BruceTanner/EPNET/README.md

# EPNET
Enterprise Computer Network Interface

This project is hardware and software for a network interface card for the Enterprise computer.
