BruceTanner/EPNET/HW/readme.txt

These files are the schematic and PCB layout for EPNET.

==============================================================================

 Copyright (C) 2015  Bruce Tanner

    These files are free: you can redistribute them and/or modify
    them under the terms of the GNU General Public License as published by
    the Free Software Foundation, either version 3 of the License, or
    (at your option) any later version.

    These files are distributed in the hope that they will be useful,
    but WITHOUT ANY WARRANTY; without even the implied warranty of
    MERCHANTABILITY or FITNESS FOR A PARTICULAR PURPOSE.  See the
    GNU General Public License for more details.

    You should have received a copy of the GNU General Public License
    along with this program.  If not, see <http://www.gnu.org/licenses/>.

 If you do use or modify these files, either for their original purpose or for
 something new, I'd love to hear about it! I can be contacted by email at:

 brucetanner@btopenworld.com

==============================================================================
