BruceTanner/EPNET/HW/pcb.png

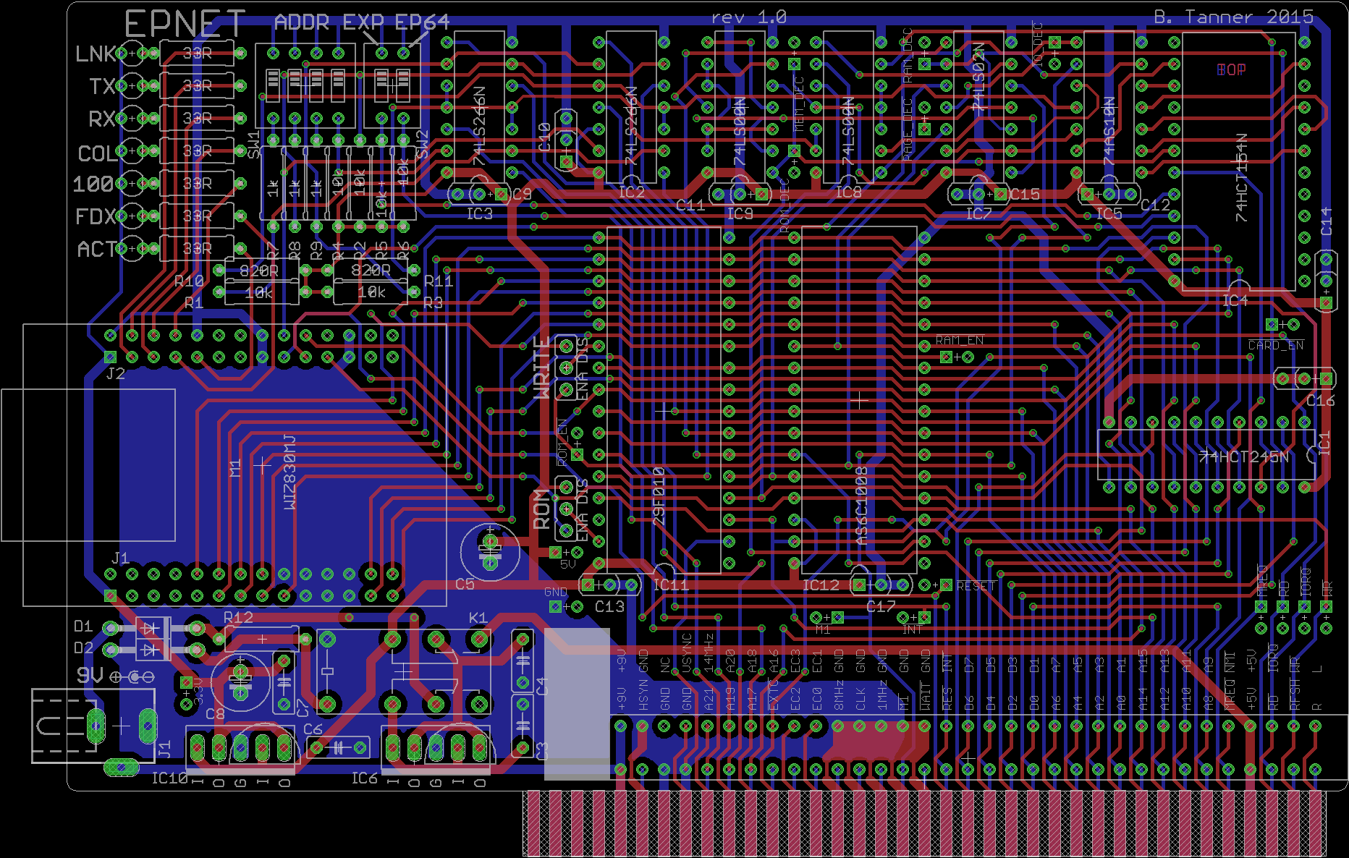
HW/pcb.png
