BruceTanner/EPNET/HW/Schematic.png

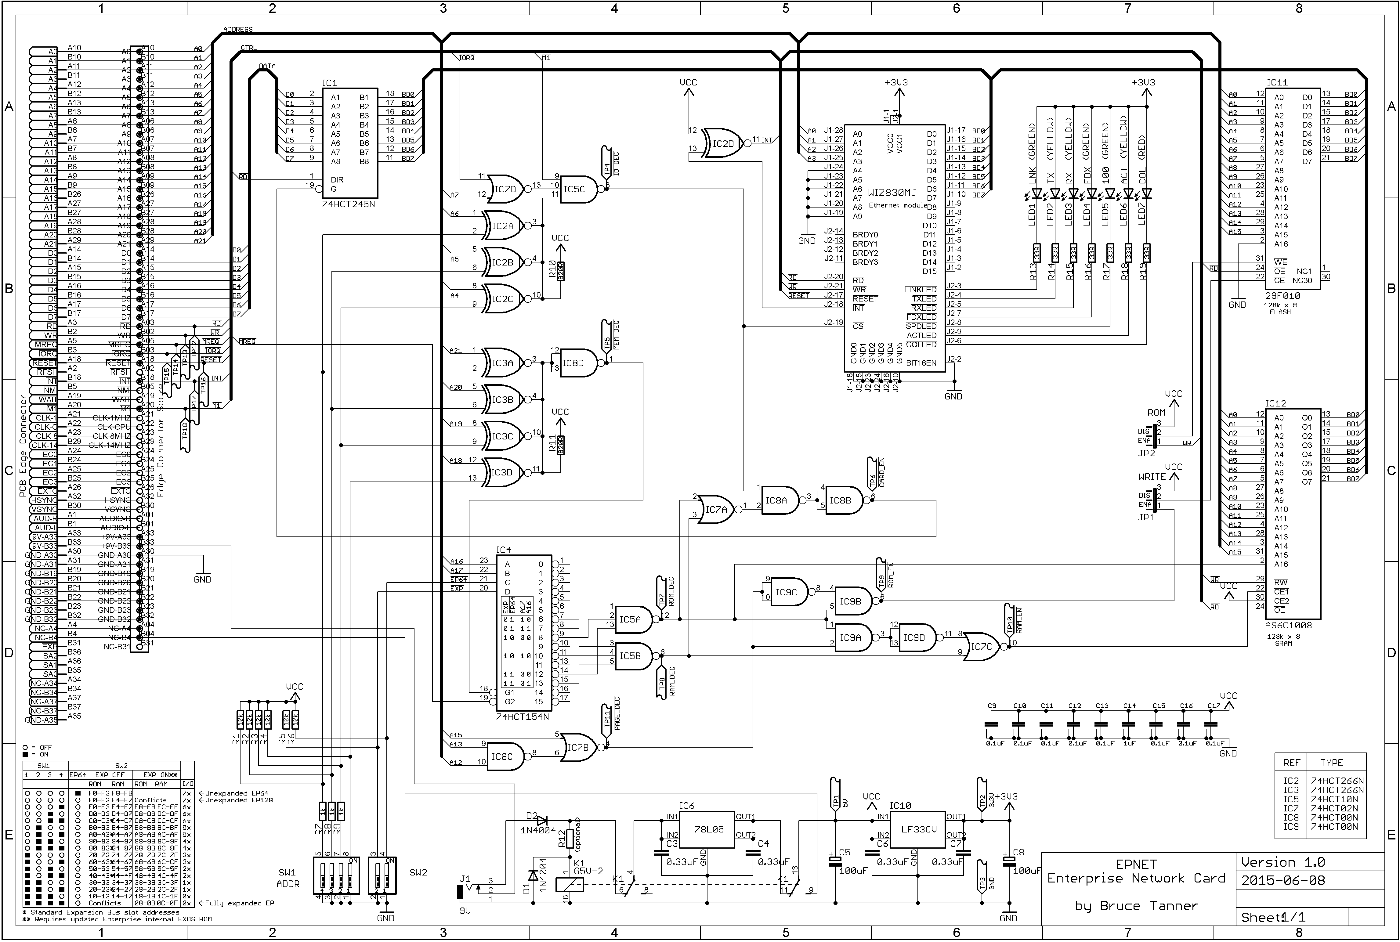
HW/Schematic.png
