BruceTanner/EPNET/HW/epnet.brd

## EAGLE design HW/epnet.brd (2015-11-03)

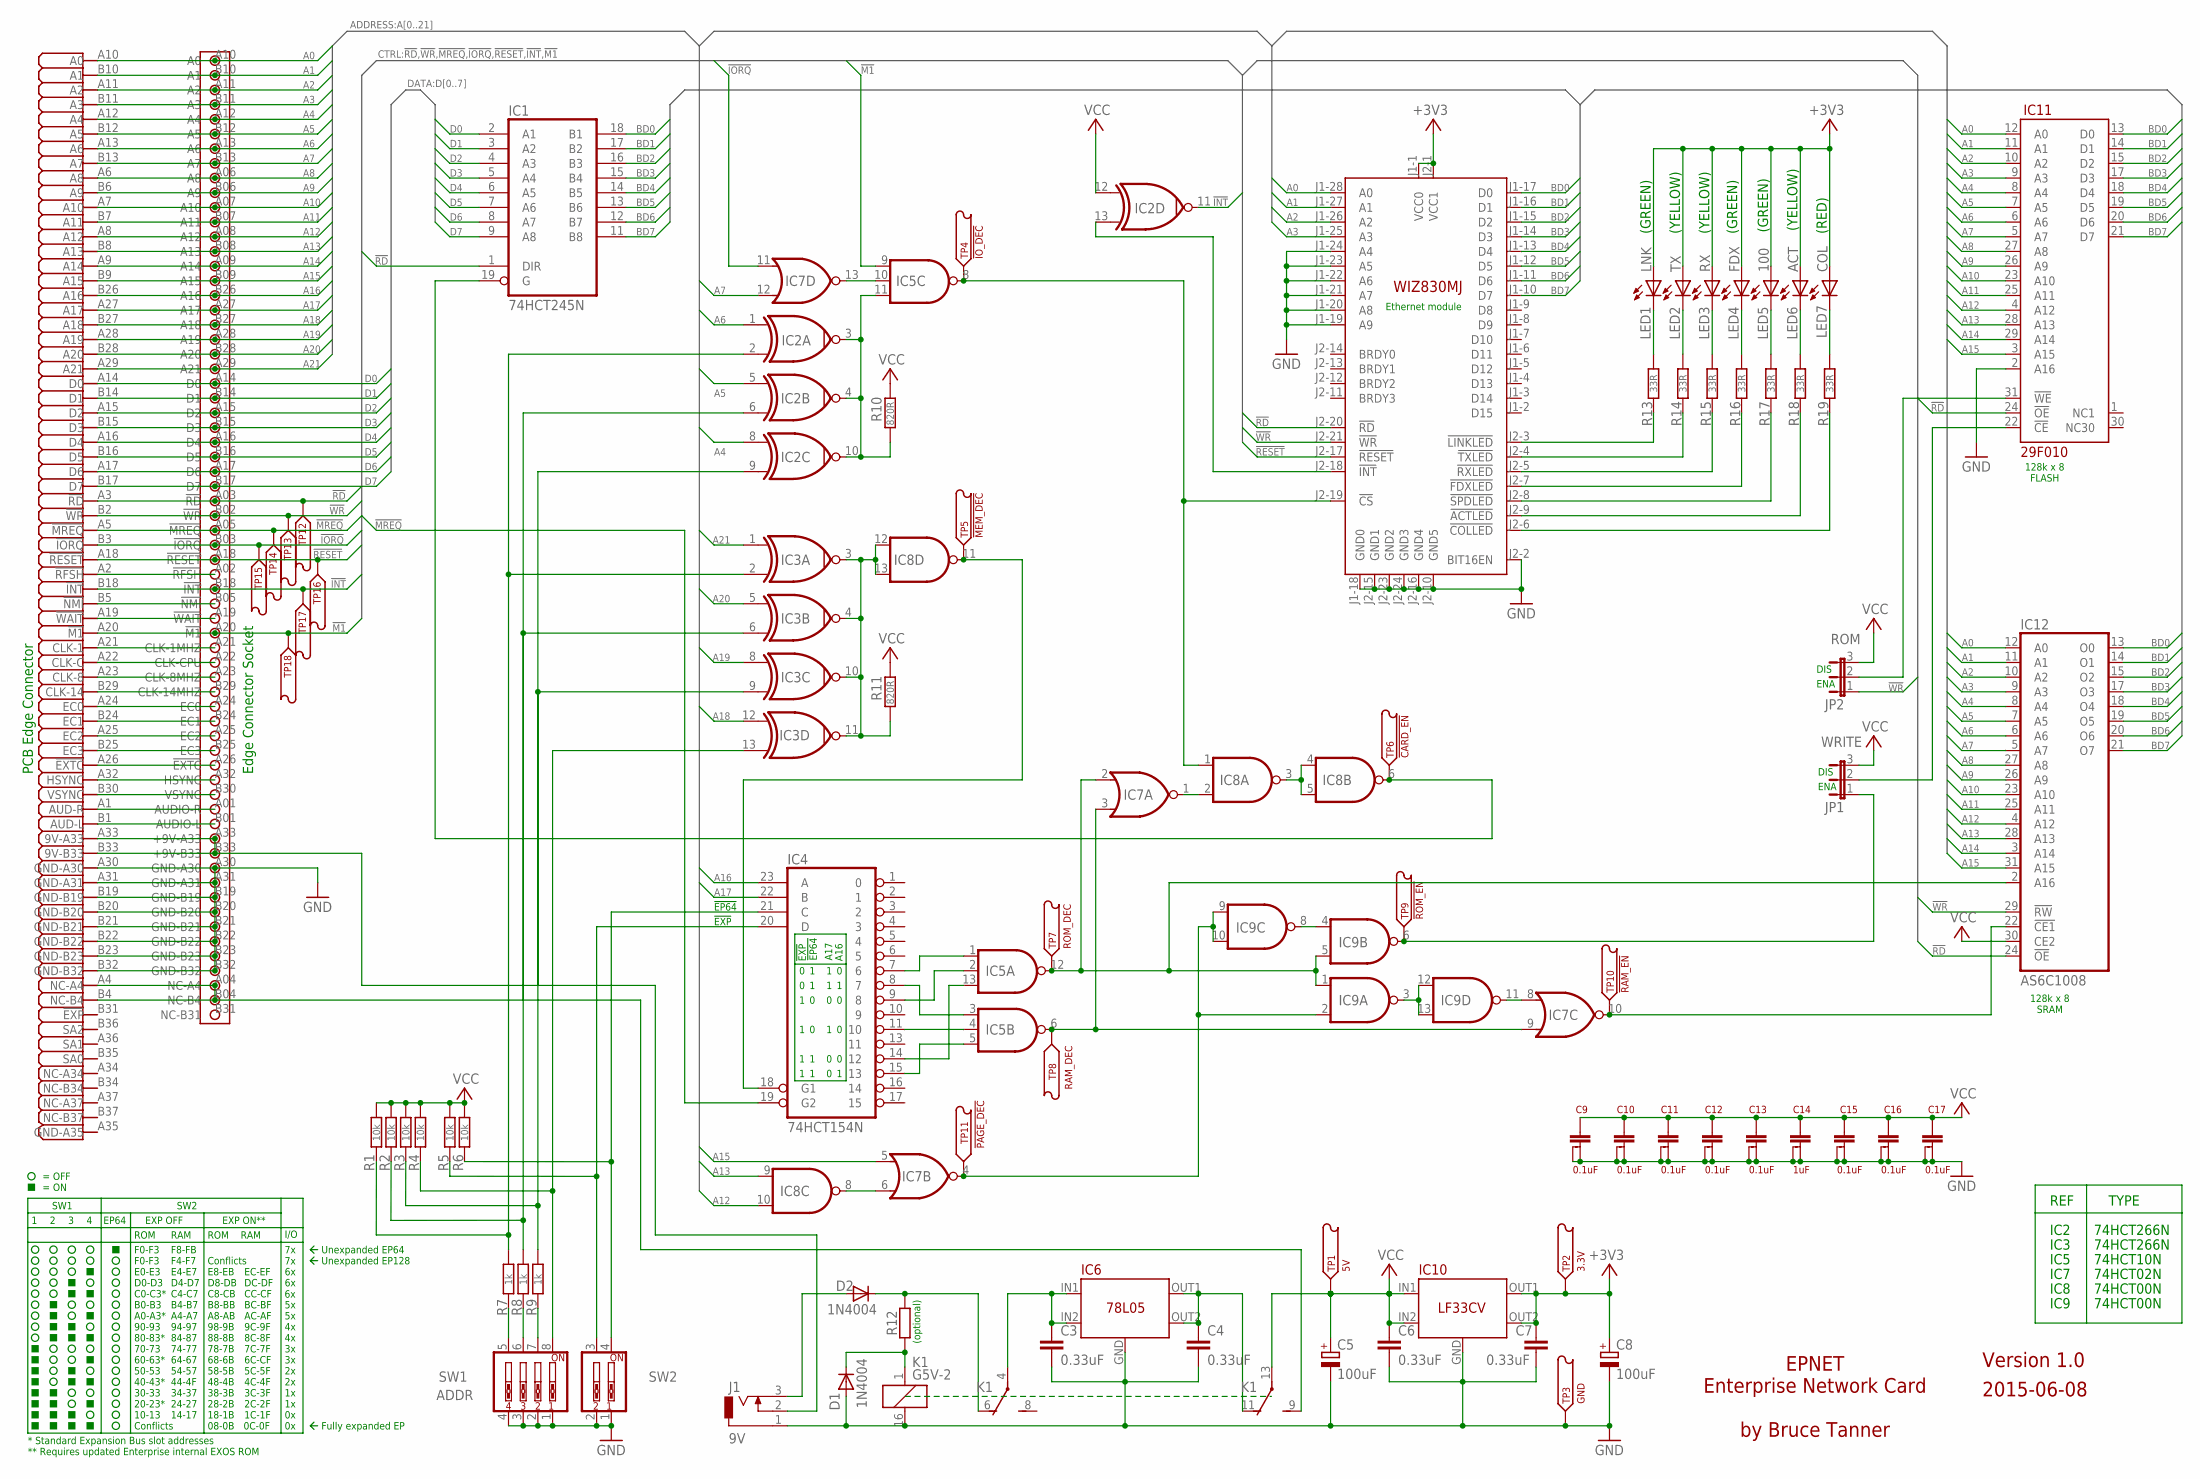
[picture p6: schematic epnet.sch]

Parts:
C1: Edge Connector; CON-EDGE
C2: CON-EXPANSION; EXPSOCKET
C3, C4, C6, C7: 0.33uF; C050-025X075
C5, C8: 100uF; E2,5-7
C9, C10, C11, C12, C13, C15, C16, C17: 0.1uF; CAPACITOR
C14: 1uF; CAPACITOR
D1, D2: 1N4004; DO41-10
IC1: 74HCT245N; DIL20
IC2, IC3: 74LS266N; DIL14
IC4: 74HCT154N; DIL24-6
IC5: 74AS10N; DIL14
IC6: 78L05; REGULATOR
IC7: 74LS02N; DIL14
IC8, IC9: 74LS00N; DIL14
IC10: LF33CV; REGULATOR
IC11: 29F010; 20F010
IC12: AS6C1008; DIL32
J1: 9V; DCJ0202
JP1: WRITE; JP2
JP2: ROM; JP2
K1: G5V-2
LED1: LNK; LED3MM
LED2: TX; LED3MM
LED3: RX; LED3MM
LED4: FDX; LED3MM
LED5: 100; LED3MM
LED6: ACT; LED3MM
LED7: COL; LED3MM
M1: WIZ830MJ
R1, R2, R3, R4, R5, R6: 10k; 0309/10
R7, R8, R9: 1k; 0309/10
R10, R11: 820R; 0309/10
R12: R-EU_0309/10; 0309/10
R13, R14, R15, R16, R17, R18, R19: 33R; 0309/10
SW1: ADDR; EDG-04
SW2: SW_DIP-2; EDG-02
TP1: 5V; TESTPOINT
TP2: 3.3V; TESTPOINT
TP3: GND; TESTPOINT
TP4: !IO_DEC; TESTPOINT
TP5: !MEM_DEC; TESTPOINT
TP6: !CARD_EN; TESTPOINT
TP7: ROM_DEC; TESTPOINT
TP8: RAM_DEC; TESTPOINT
TP9: !ROM_EN; TESTPOINT
TP10: !RAM_EN; TESTPOINT
TP11: !PAGE_DEC; TESTPOINT
TP12: !RD; TESTPOINT
TP13: !WR; TESTPOINT
TP14: !MREQ; TESTPOINT
TP15: !IORQ; TESTPOINT
TP16: !RESET; TESTPOINT
TP17: !INT; TESTPOINT
TP18: !M1; TESTPOINT

Connections:
!CARD_ENABLE: IC1.19 (G), IC8.6 (O), TP6.P$1
!EP64: IC4.21 (C), R6.1, SW2.4
!INT: C1.B18 (!INT), C2.B18 (!INT), IC2.11 (O), TP17.P$1
!IORQ: C1.B3 (!IORQ), C2.B03 (!IORQ), IC7.11 (I0), TP15.P$1
!IO_DECODE: IC5.8 (O), IC8.1 (I0), M1.J2-19 (!CS), TP4.P$1
!M1: C1.A20 (!M1), C2.A20 (!M1), IC5.9 (I0), TP18.P$1
!MEM_DEC: IC4.18 (G1), IC8.11 (O), TP5.P$1
!MREQ: C1.A5 (!MREQ), C2.A05 (!MREQ), IC4.19 (G2), TP14.P$1
!RAM_ENABLE: IC7.10 (O), IC12.22 (!CE1), TP10.P$1
!RD: C1.A3 (!RD), C2.A03 (!RD), IC1.1 (DIR), IC11.24 (!OE), IC12.24 (!OE), M1.J2-20 (!RD), TP12.P$1
!RESET: C1.A18 (!RESET), C2.A18 (!RESET), M1.J2-17 (!RESET), TP16.P$1
!ROM_ENABLE: IC9.6 (O), JP1.1, TP9.P$1
!WR: C1.B2 (!WR), C2.B02 (!WR), IC12.29 (!RW), JP2.1, M1.J2-21 (!WR), TP13.P$1
+3V3: C7.1, C8.+, IC10.OUT1, IC10.OUT2, LED1.A, LED2.A, LED3.A, LED4.A, LED5.A, LED6.A, LED7.A, M1.J1-1 (VCC0), M1.J2-1 (VCC1), TP2.P$1
A0: C1.A10 (A0), C2.A10 (A0), IC11.12 (A0), IC12.12 (A0), M1.J1-28 (A0)
A1: C1.B10 (A1), C2.B10 (A1), IC11.11 (A1), IC12.11 (A1), M1.J1-27 (A1)
A2: C1.A11 (A2), C2.A11 (A2), IC11.10 (A2), IC12.10 (A2), M1.J1-26 (A2)
A3: C1.B11 (A3), C2.B11 (A3), IC11.9 (A3), IC12.9 (A3), M1.J1-25 (A3)
A4: C1.A12 (A4), C2.A12 (A4), IC2.8 (I0), IC11.8 (A4), IC12.8 (A4)
A5: C1.B12 (A5), C2.B12 (A5), IC2.5 (I0), IC11.7 (A5), IC12.7 (A5)
A6: C1.A13 (A6), C2.A13 (A6), IC2.1 (I0), IC11.6 (A6), IC12.6 (A6)
A7: C1.B13 (A7), C2.B13 (A7), IC7.12 (I1), IC11.5 (A7), IC12.5 (A7)
A8: C1.A6 (A8), C2.A06 (A8), IC11.27 (A8), IC12.27 (A8)
A9: C1.B6 (A9), C2.B06 (A9), IC11.26 (A9), IC12.26 (A9)
A10: C1.A7 (A10), C2.A07 (A10), IC11.23 (A10), IC12.23 (A10)
A11: C1.B7 (A11), C2.B07 (A11), IC11.25 (A11), IC12.25 (A11)
A12: C1.A8 (A12), C2.A08 (A12), IC8.10 (I1), IC11.4 (A12), IC12.4 (A12)
A13: C1.B8 (A13), C2.B08 (A13), IC8.9 (I0), IC11.28 (A13), IC12.28 (A13)
A14: C1.A9 (A14), C2.A09 (A14), IC11.29 (A14), IC12.3 (A14)
A15: C1.B9 (A15), C2.B09 (A15), IC7.5 (I0), IC11.3 (A15), IC12.31 (A15)
A16: C1.B26 (A16), C2.B26 (A16), IC4.23 (A)
A17: C1.A27 (A17), C2.A27 (A17), IC4.22 (B)
A18: C1.B27 (A18), C2.B27 (A18), IC3.12 (I0)
A19: C1.A28 (A19), C2.A28 (A19), IC3.8 (I0)
A20: C1.B28 (A20), C2.B28 (A20), IC3.5 (I0)
A21: C1.A29 (A21), C2.A29 (A21), IC3.1 (I0)
BD0: IC1.18 (B1), IC11.13 (D0), IC12.13 (O0), M1.J1-17 (D0)
BD1: IC1.17 (B2), IC11.14 (D1), IC12.14 (O1), M1.J1-16 (D1)
BD2: IC1.16 (B3), IC11.15 (D2), IC12.15 (O2), M1.J1-15 (D2)
BD3: IC1.15 (B4), IC11.17 (D3), IC12.17 (O3), M1.J1-14 (D3)
BD4: IC1.14 (B5), IC11.18 (D4), IC12.18 (O4), M1.J1-13 (D4)
BD5: IC1.13 (B6), IC11.19 (D5), IC12.19 (O5), M1.J1-12 (D5)
BD6: IC1.12 (B7), IC11.20 (D6), IC12.20 (O6), M1.J1-11 (D6)
BD7: IC1.11 (B8), IC11.21 (D7), IC12.21 (O7), M1.J1-10 (D7)
D0: C1.A14 (D0), C2.A14 (D0), IC1.2 (A1)
D1: C1.B14 (D1), C2.B14 (D1), IC1.3 (A2)
D2: C1.A15 (D2), C2.A15 (D2), IC1.4 (A3)
D3: C1.B15 (D3), C2.B15 (D3), IC1.5 (A4)
D4: C1.A16 (D4), C2.A16 (D4), IC1.6 (A5)
D5: C1.B16 (D5), C2.B16 (D5), IC1.7 (A6)
D6: C1.A17 (D6), C2.A17 (D6), IC1.8 (A7)
D7: C1.B17 (D7), C2.B17 (D7), IC1.9 (A8)
GND: C1.A30 (GND-A30), C1.A31 (GND-A31), C1.B19 (GND-B19), C1.B20 (GND-B20), C1.B21 (GND-B21), C1.B22 (GND-B22), C1.B23 (GND-B23), C1.B32 (GND-B32), C2.A30 (GND-A30), C2.A31 (GND-A31), C2.B19 (GND-B19), C2.B20 (GND-B20), C2.B21 (GND-B21), C2.B22 (GND-B22), C2.B23 (GND-B23), C2.B32 (GND-B32), C3.2, C4.2, C5.-, C6.2, C7.2, C8.-, C9.P$2, C9.P$3, C10.P$2, C10.P$3, C11.P$2, C11.P$3, C12.P$2, C12.P$3, C13.P$2, C13.P$3, C14.P$2, C14.P$3, C15.P$2, C15.P$3, C16.P$2, C16.P$3, C17.P$2, C17.P$3, D1.A, IC1.10 (GND), IC2.7 (GND), IC3.7 (GND), IC4.12 (GND), IC5.7 (GND), IC6.GND, IC7.7 (GND), IC8.7 (GND), IC9.7 (GND), IC10.GND, IC11.2 (A16), IC11.16 (GND), IC12.16 (GND), J1.1, K1.16 (2), M1.J1-18 (GND0), M1.J1-19 (A9), M1.J1-20 (A8), M1.J1-21 (A7), M1.J1-22 (A6), M1.J1-23 (A5), M1.J1-24 (A4), M1.J2-2 (BIT16EN), M1.J2-10 (GND5), M1.J2-15 (GND1), M1.J2-16 (GND4), M1.J2-23 (GND2), M1.J2-24 (GND3), SW1.1, SW1.2, SW1.3, SW1.4, SW2.1, SW2.2, TP3.P$1
GND-A35: C1.A35 (GND-A35)
unnamed: C1.A2 (!RFSH), C2.A02 (!RFSH)
unnamed: IC9.4 (I0), IC9.8 (O)
unnamed: R7.1, SW1.5
unnamed: IC3.13 (I1), R4.1, SW1.8
unnamed: R8.1, SW1.6
unnamed: R9.1, SW1.7
unnamed: M1.J2-3 (!LINKLED), R13.1
unnamed: IC4.7 (6), IC5.1 (I0)
unnamed: IC5.10 (I1), IC7.13 (O)
unnamed: IC4.8 (7), IC5.3 (I0)
unnamed: IC4.15 (13), IC5.5 (I2)
unnamed: IC2.9 (I1), IC3.9 (I1), R3.1, R9.2
unnamed: M1.J2-4 (!TXLED), R14.1
unnamed: IC9.3 (O), IC9.12 (I0), IC9.13 (I1)
unnamed: IC4.9 (8), IC5.2 (I1)
unnamed: IC4.11 (10), IC5.4 (I1)
unnamed: IC4.14 (12), IC5.13 (I2)
unnamed: IC7.1 (O), IC8.2 (I1)
unnamed: IC7.8 (I0), IC9.11 (O)
unnamed: C1.B5 (!NMI), C2.B05 (!NMI)
unnamed: D1.C, K1.1, R12.1
unnamed: IC8.3 (O), IC8.4 (I0), IC8.5 (I1)
unnamed: IC7.6 (I1), IC8.8 (O)
unnamed: M1.J2-5 (!RXLED), R15.1
unnamed: M1.J2-7 (!FDXLED), R16.1
unnamed: M1.J2-8 (!SPDLED), R17.1
unnamed: M1.J2-9 (!ACTLED), R18.1
unnamed: M1.J2-6 (!COLLED), R19.1
unnamed: LED1.K (C), R13.2
unnamed: LED2.K (C), R14.2
unnamed: LED3.K (C), R15.2
unnamed: LED4.K (C), R16.2
unnamed: LED5.K (C), R17.2
unnamed: LED6.K (C), R18.2
unnamed: LED7.K (C), R19.2
unnamed: IC2.3 (O), IC2.4 (O), IC2.10 (O), IC5.11 (I2), R10.1
unnamed: IC3.3 (O), IC3.4 (O), IC3.10 (O), IC3.11 (O), IC8.12 (I0), IC8.13 (I1), R11.1
unnamed: IC4.20 (D), R5.1, SW2.3
unnamed: D2.C, K1.6 (O), R12.2
unnamed: D2.A, J1.3
unnamed: C1.A33 (9V-A33), C1.B33 (9V-B33), C2.A33 (+9V-A33), C2.B33 (+9V-B33), J1.2
unnamed: IC11.22 (!CE), JP1.2
unnamed: IC11.31 (!WE), JP2.2
unnamed: C1.A19 (!WAIT), C2.A19 (!WAIT)
unnamed: C1.A21 (CLK-1), C2.A21 (CLK-1MHZ)
unnamed: C1.A22 (CLK-C), C2.A22 (CLK-CPU)
unnamed: C1.A23 (CLK-8), C2.A23 (CLK-8MHZ)
unnamed: C1.B29 (CLK-14), C2.B29 (CLK-14MHZ)
unnamed: C1.A24 (EC0), C2.A24 (EC0)
unnamed: C1.B24 (EC1), C2.B24 (EC1)
unnamed: C1.A25 (EC2), C2.A25 (EC2)
unnamed: C1.B25 (EC3), C2.B25 (EC3)
unnamed: C1.A26 (!EXTC), C2.A26 (!EXTC)
unnamed: C1.A32 (HSYNC), C2.A32 (HSYNC)
unnamed: C1.B30 (VSYNC), C2.B30 (VSYNC)
unnamed: C1.A1 (AUD-R), C2.A01 (AUDIO-R)
unnamed: C1.B1 (AUD-L), C2.B01 (AUDIO-L)
unnamed: C3.1, IC6.IN1, IC6.IN2, K1.4
unnamed: C1.A4 (NC-A4), C1.B4 (NC-B4), C2.A04 (NC-A4), C2.B04 (NC-B4), K1.9 (S)
unnamed: C4.1, IC6.OUT1, IC6.OUT2, K1.11 (O)
unnamed: IC2.13 (I1), M1.J2-18 (!INT)
PAGE_DECODE: IC7.4 (O), IC9.2 (I1), IC9.9 (I0), IC9.10 (I1), TP11.P$1
RAM_DECODE: IC5.6 (O), IC7.3 (I1), IC7.9 (I1), TP8.P$1
ROM_DECODE: IC5.12 (O), IC7.2 (I0), IC9.1 (I0), IC9.5 (I1), IC12.2 (A16), TP7.P$1
SA1: IC2.6 (I1), IC3.6 (I1), R2.1, R8.2
SA2: IC2.2 (I1), IC3.2 (I1), R1.1, R7.2
VCC: C5.+, C6.1, C9.P$1, C10.P$1, C11.P$1, C12.P$1, C13.P$1, C14.P$1, C15.P$1, C16.P$1, C17.P$1, IC1.20 (VCC), IC2.12 (I0), IC2.14 (VCC), IC3.14 (VCC), IC4.24 (VCC), IC5.14 (VCC), IC7.14 (VCC), IC8.14 (VCC), IC9.14 (VCC), IC10.IN1, IC10.IN2, IC11.32 (VCC), IC12.30 (CE2), IC12.32 (VCC), JP1.3, JP2.3, K1.13, R1.2, R2.2, R3.2, R4.2, R5.2, R6.2, R10.2, R11.2, TP1.P$1

Notes on the sheet:
74HCT266N
!EP64
!EXP
EPNET Enterprise Network Card by Bruce Tanner
2015-06-08
74HCT10N
74HCT00N
74HCT02N
REF
TYPE
IC2
IC3
IC7
IC5
IC9
IC8
ROM
RAM
I/O
F0-F3
F4-F7
F8-FB
D0-D3
D4-D7
E0-E3
E4-E7
C0-C3*
C4-C7
B0-B3
B4-B7
A8-AB
AC-AF
90-93
94-97
88-8B
8C-8F
68-6B
6C-CF
70-73
74-77
50-53
54-57
48-4B
4C-4F
30-33
34-37
28-2B
2C-2F
10-13
14-17
08-0B
0C-0F
A17
A16
Version 1.0
PCB Edge Connector
Edge Connector Socket
SW1
EP64
Unexpanded EP64
Unexpanded EP128
Fully expanded EP
128k x 8 FLASH
128k x 8 SRAM
(optional)
Ethernet module
EXP OFF
EXP ON**
E8-EB
EC-EF
D8-DB
DC-DF
C8-CB
CC-CF
SW2
B8-BB
BC-BF
A0-A3*
A4-A7
80-83*
84-87
98-9B
9C-9F
78-7B
7C-7F
60-63*
64-67
58-5B
5C-5F
40-43*
44-4F
38-3B
3C-3F
20-23*
24-27
18-1B
1C-1F
Conflicts
* Standard Expansion Bus slot addresses
** Requires updated Enterprise internal EXOS ROM
= ON
= OFF
ENA
DIS
(RED)
(GREEN)
(YELLOW)

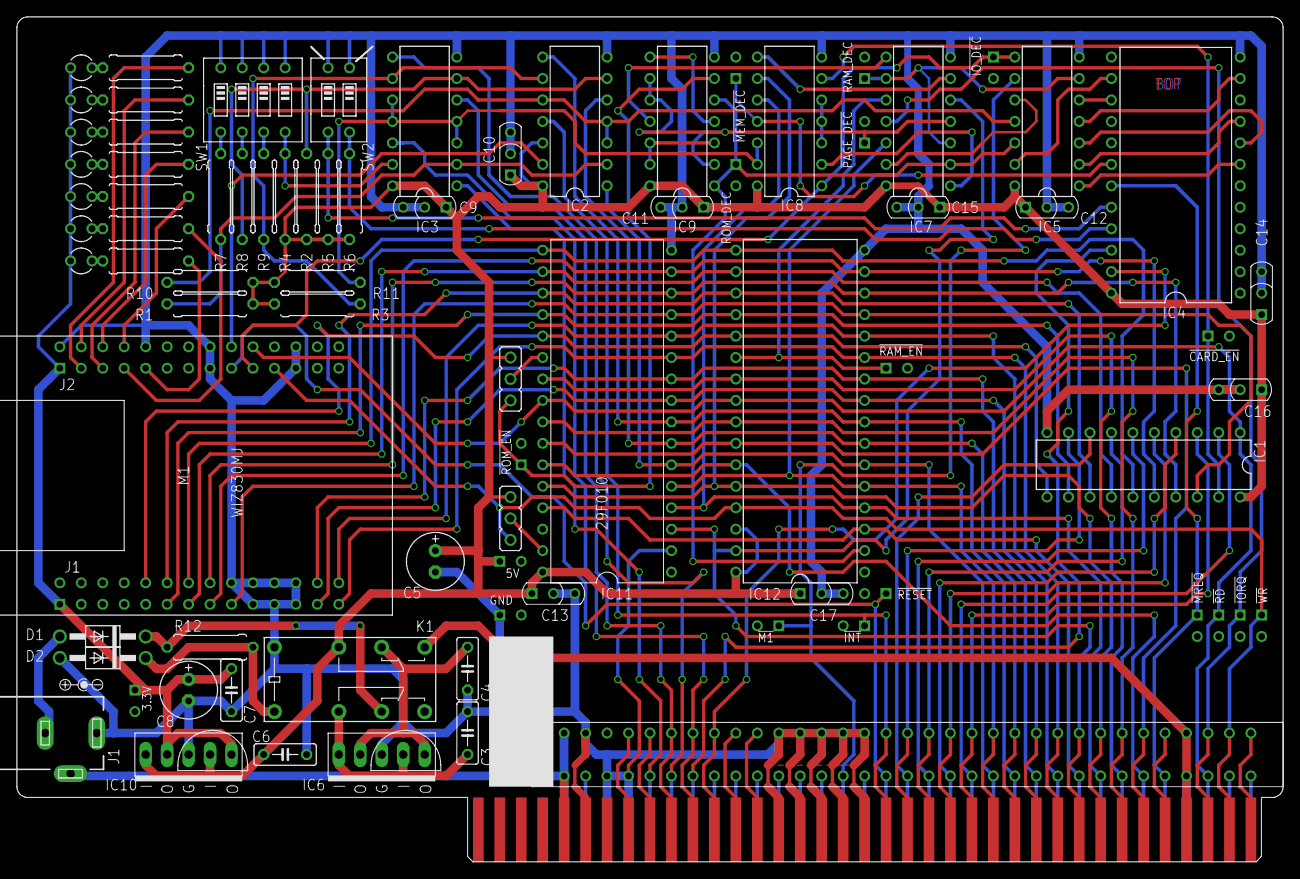
[picture p7: board epnet.brd from above]

Board: 2 copper layers, 149.9 x 100.0 mm, 82 parts (0 on the bottom side), 120 nets.
